stefanferry/PiTrac/3D Printed Parts/Enclosure Stack/Part/Print/Spacer.stl

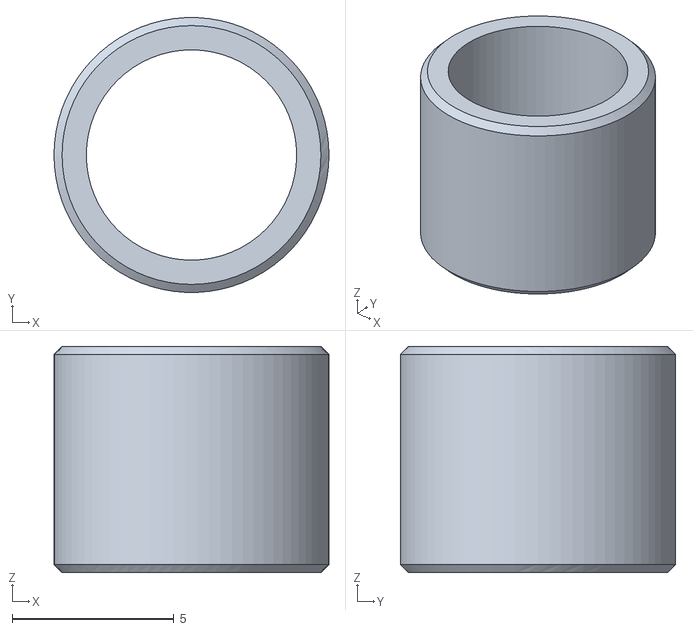
[picture p1: CAD file, 2025-12-08]
3D Printed Parts/Enclosure Stack/Part/Print/Spacer.stl
8.50 x 8.49 x 7.00
