stefanferry/PiTrac/3D Printed Parts/Enclosure Stack/Part/Print/ConnectorBoardv0p2_Carrier.stl

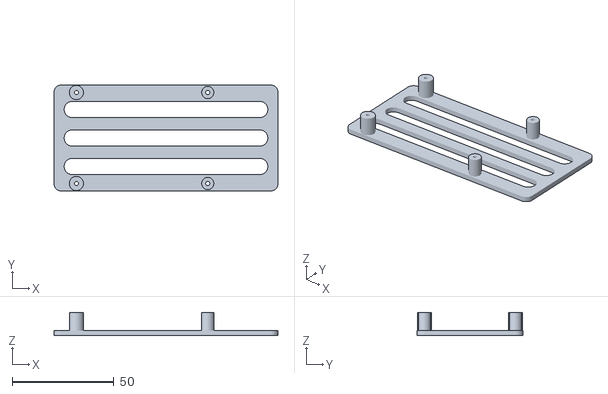
[picture p2: CAD file, 2025-12-08]
3D Printed Parts/Enclosure Stack/Part/Print/ConnectorBoardv0p2_Carrier.stl
110.0 x 52.0 x 11.5
