stefanferry/PiTrac/3D Printed Parts/Enclosure Stack/Part/Print/LED_Eyeball.stl

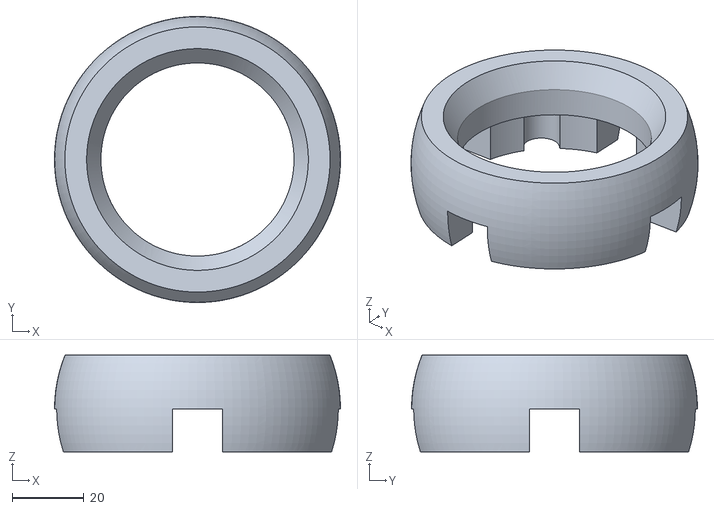
[picture p3: CAD file, 2025-12-06]
3D Printed Parts/Enclosure Stack/Part/Print/LED_Eyeball.stl
80.0 x 80.0 x 27.0
