stefanferry/PiTrac/3D Printed Parts/Enclosure Stack/Part/Print/EyeScreen.stl

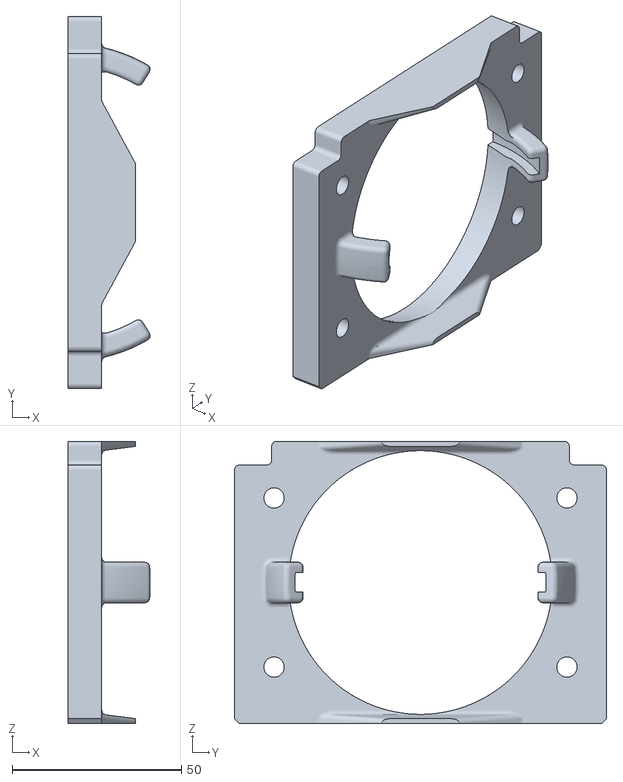
[picture p4: CAD file, 2025-12-06]
3D Printed Parts/Enclosure Stack/Part/Print/EyeScreen.stl
24.3 x 110.0 x 83.5
