stefanferry/PiTrac/3D Printed Parts/Enclosure Stack/Part/Print/LinePower_Cover.stl

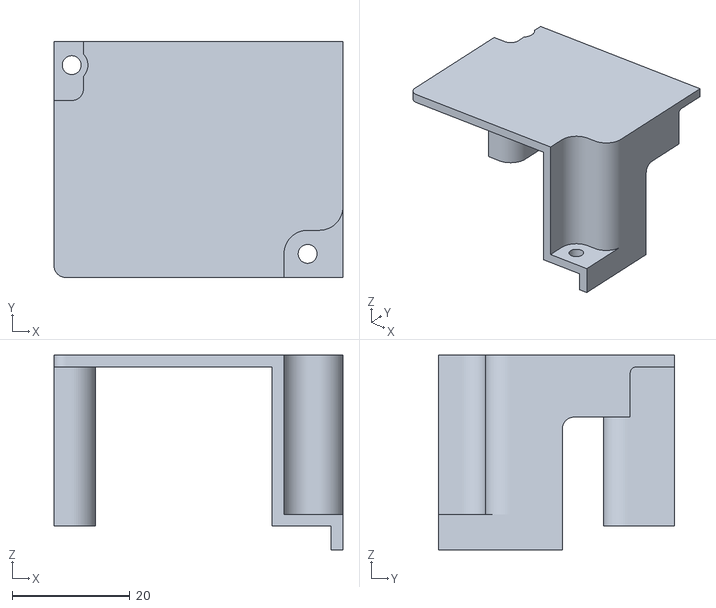
[picture p5: CAD file, 2025-12-06]
3D Printed Parts/Enclosure Stack/Part/Print/LinePower_Cover.stl
49.0 x 40.0 x 33.0
