stefanferry/PiTrac/3D Printed Parts/Enclosure Stack/Part/Print/Carrier_Clamps.stl

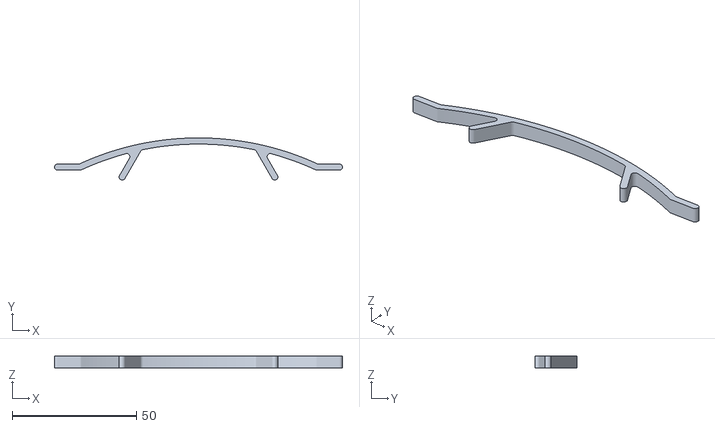
[picture p6: CAD file, 2025-12-06]
3D Printed Parts/Enclosure Stack/Part/Print/Carrier_Clamps.stl
116.0 x 17.0 x 5.00
