stefanferry/PiTrac/3D Printed Parts/Enclosure Stack/Part/Print/EyeScreen_Clamp.stl

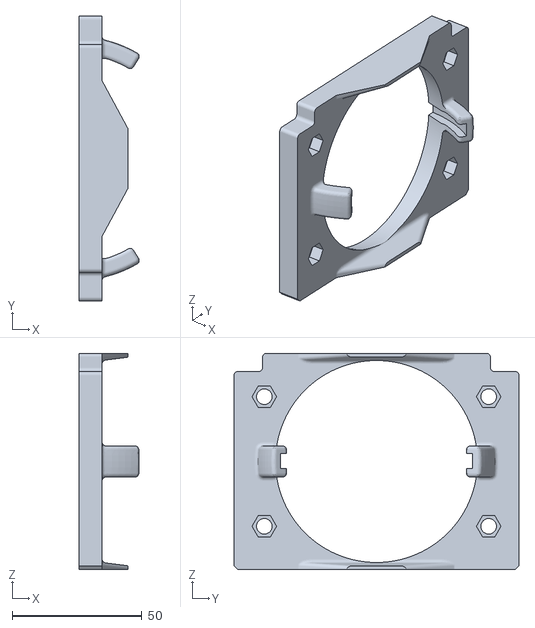
[picture p7: CAD file, 2025-12-06]
3D Printed Parts/Enclosure Stack/Part/Print/EyeScreen_Clamp.stl
23.3 x 110.0 x 83.5
