stefanferry/PiTrac/3D Printed Parts/Enclosure Stack/Part/Print/Pi5_Carrier.stl

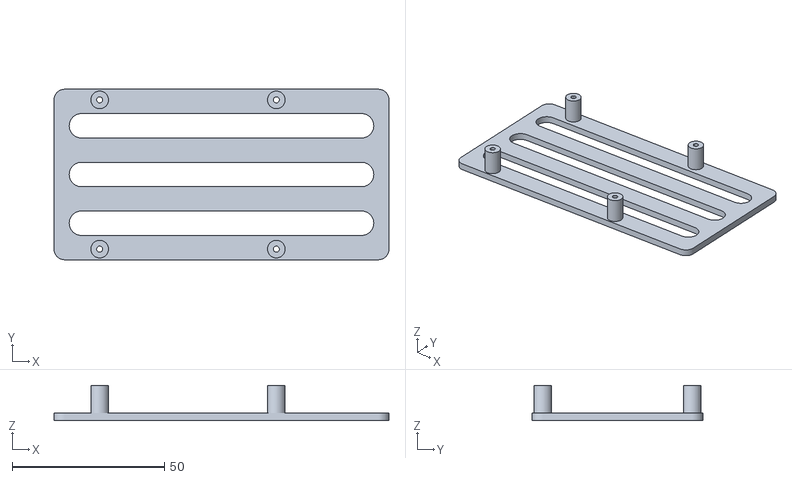
[picture p8: CAD file, 2025-12-06]
3D Printed Parts/Enclosure Stack/Part/Print/Pi5_Carrier.stl
110.0 x 56.0 x 11.5
