stefanferry/PiTrac/3D Printed Parts/Enclosure Stack/Part/Print/Stack_Module.stl

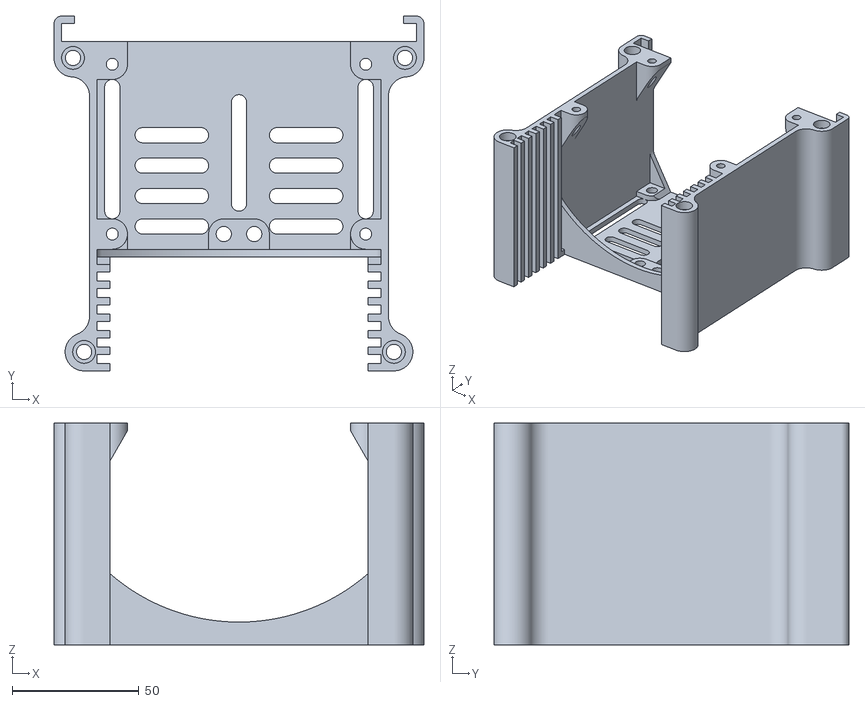
[picture p9: CAD file, 2025-12-06]
3D Printed Parts/Enclosure Stack/Part/Print/Stack_Module.stl
146.0 x 140.0 x 87.5
