stefanferry/PiTrac/3D Printed Parts/Enclosure Stack/Part/Print/ConnectorBoardv2__Carrier.stl

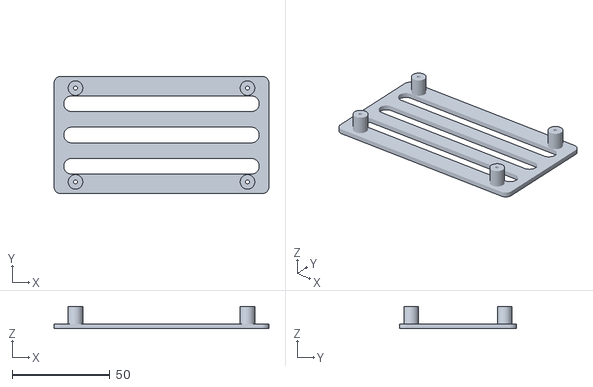
[picture p10: CAD file, 2025-12-06]
3D Printed Parts/Enclosure Stack/Part/Print/ConnectorBoardv2__Carrier.stl
110.0 x 60.0 x 11.5
