stefanferry/PiTrac/3D Printed Parts/Enclosure Stack/Part/Print/IMX296-MPI_Eyeball_6mm.stl

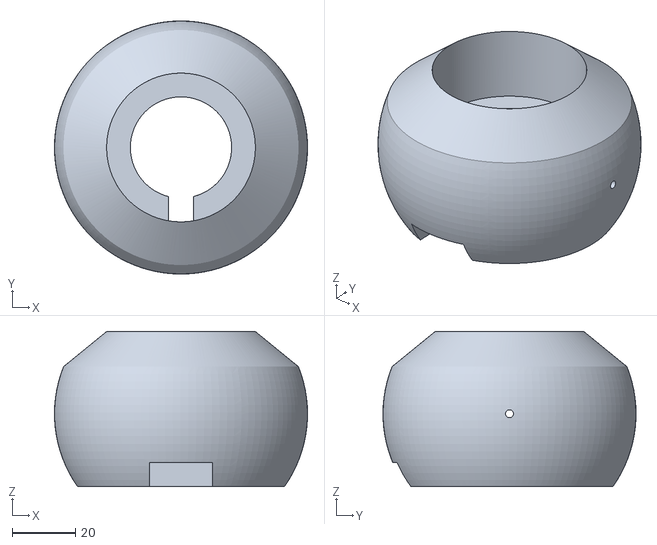
[picture p11: CAD file, 2025-12-06]
3D Printed Parts/Enclosure Stack/Part/Print/IMX296-MPI_Eyeball_6mm.stl
80.0 x 80.0 x 49.0
