stefanferry/PiTrac/3D Printed Parts/Enclosure Stack/Part/Print/Foot.stl

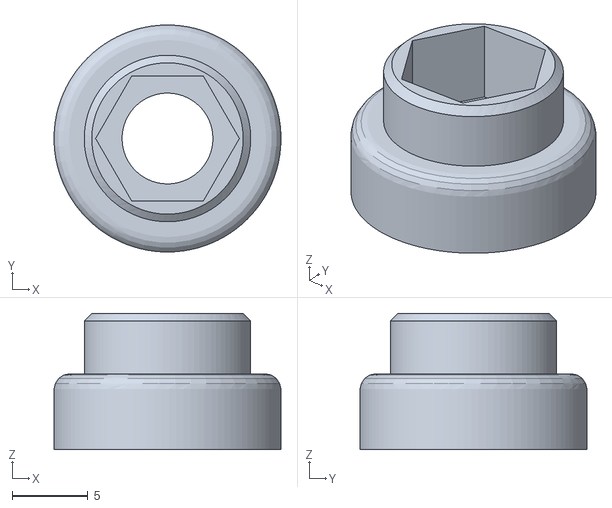
[picture p12: CAD file, 2025-12-06]
3D Printed Parts/Enclosure Stack/Part/Print/Foot.stl
15.0 x 15.0 x 9.00
