stefanferry/PiTrac/3D Printed Parts/Enclosure Stack/Part/Print/LED_Clamp.stl

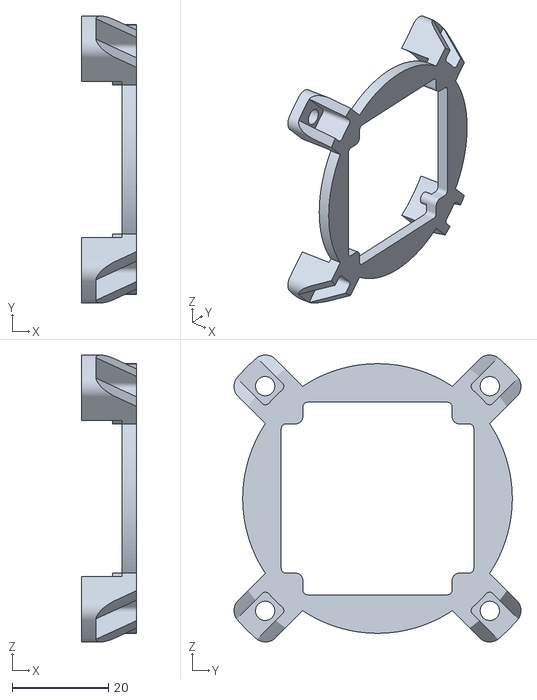
[picture p13: CAD file, 2025-12-06]
3D Printed Parts/Enclosure Stack/Part/Print/LED_Clamp.stl
11.5 x 59.6 x 59.6
