stefanferry/PiTrac/(commit log)

2025-12-06 Add first enclosure stack parts and README
    [Carrier_Clamps.stl, ConnectorBoardv2__Carrier.stl, EyeScreen.stl, EyeScreen_Clamp.stl, Foot.stl, IMX296-MPI_Eyeball_6mm.stl, LED_Clamp.stl, LED_Eyeball.stl]
2025-12-07 Update README and assembly instructions + Cover stl
2025-12-07 Update README.md
    increased nominal distance from 25 to 30 mm
2025-12-08 Change from 10 to 12 mm in hole diameter
2025-12-08 Added ConnectorBoardv0p2_Carrier
    [ConnectorBoardv0p2_Carrier.stl]
2025-12-08 Added spacers and created legacy folder
    [ConnectorBoardv0p2_Carrier.stl, Spacer.stl]
